shulltronics/kicad_library/parts_inventory.ods

Sheet: Parts Inventory
Shulltronics PN | Description | Category | Part Type | Manufacturer | Manufacturer PN | Supplier A | Supplier A PN | Supplier B | Supplier B PN | Unit Cost
3000 | 5mm 940nm LEDs Infrared Emitter and IR Receiver Diode, 10pk | Optoelectonics | THT | Gikfun | EK8443 | Amazon | B01HGIQ8NG |  |  | $5.78
3001 | CONN SOCKET 22-24AWG CRIMP TIN | Connectors | N/A | Molex | 16020086 | Digikey | WM2510CT-ND |  |  | $0.23
3002 | Sensor Photodiode 3mm 940nm Radial | Optoelectonics | THT | Everlight Electronics | PD204-6C | Digikey | 1080-1140-ND |  |  | $0.47
3003 | EMITTER IR 940NM 100MA RADIAL | Optoelectonics | THT | Everlight Electronics | IR333-A | Digikey | 1080-1080-ND |  |  | $0.44
3004 | RES 475 OHM 1/4W 1% AXIAL | Passives | THT | Yageo | MFR-25FBF52-475R | Digikey | 475XBK-ND |  |  | $0.10
3005 | RES 22.1K OHM 1/4W 1% AXIAL | Passives | THT | Yageo | MFR-25FBF52-22K1 | Digikey | 22.1KXBK-ND |  |  | $0.10
3006 | RES 2.21K OHM 1/4W 1% AXIAL | Passives | THT | Yageo | MFR-25FBF52-2K21 | Digikey | 2.21KXBK-ND |  |  | $0.10
3007 | RES 33.2K OHM 1/4W 1% AXIAL | Passives | THT | Yageo | MFR-25FBF52-33K2 | Digikey | 33.2KXBK-ND |  |  | $0.10
3008 | RES 10K OHM 1/4W 1% AXIAL | Passives | THT | Yageo | MFR-25FBF52-10K | Digikey | 10.0KXBK-ND |  |  | $0.10
3009 | RES 221 OHM 1/4W 1% AXIAL | Passives | THT | Yageo | MFR-25FBF52-221R | Digikey | 221XBK-ND |  |  | $0.10
3010 | 0.1µF -20%, +80% 25V Ceramic Capacitor Y5V (F) Radial | Passives | THT | Vishay BC Components | K104Z15Y5VE5TL2 | Digikey | BC1148CT-ND |  |  | $0.25
3011 | SWITCH PUSH SPST-NO 0.01A 12V BLACK | Passives | THT | Cherry Americas LLC | MX1A-11NN | Digikey | CH162-ND |  |  | $0.93
3012 | Graphic LCD 128x64 STN YLW-GRN LED Backlight | Optoelectonics | THT | Sparkfun Electronics | LCD-00710 | Sparkfun Electronics | LCD-00710 |  |  | $23.95
3013 | Resistive Touch screen - 3.7" Diagonal | Passives | N/A | Adafruit | 333 | Digikey | 1528-1221-ND |  |  | $5.95
3014 | Adafruit Touch Screen Breakout Board for 4 pin 1.0mm FPC | PCB | THT | Adafruit | 3575 | Digikey | 1528-2358-ND |  |  | $2.50
3015 | Feather Teensy 3.x Adapter | Development Board | THT | Adafruit | 3200 | Digikey | 1528-1721-ND |  |  | $5.95
3016 | Trimmer 10k Ohm 0.5W PC Pin Top | Passives | THT | Bourns Inc | 3362P-1-103LF | Digikey | 3362P-1-103LF |  |  | $1.02
3017 | 7 Segment Display 0.3” YLW-GRN 10DIP | Optoelectonics | THT | Inolux | INND-TS30YGAB | Digikey | 1830-1145-ND |  |  | $1.21
3018 | 7 Segment Display 0.3” RED 10DIP | Optoelectonics | THT | Inolux | INND-TS30RAB | Digikey | 1830-1146-ND |  |  | $1.21
3019 | LED Backlighting FSTN (-) Transmiss Black Backround | Optoelectonics | THT | Electronic Assembly | EA DOGXL160S-7 | Mouser | 790-EADOGXL160S-7 |  |  | $22.34
3020 | LED Backlighting Red LED Backlight For DOG-XL Series | Optoelectonics | THT | Electronic Assembly | EA LED78x64-R | Mouser | 790-EALED78X64-R |  |  | $6.83
3021 | 7 Segment Display 0.3” RED 14DIP | Optoelectonics | THT | Hewlett-Packard | 5082-7730 | Electronic Surplus | 150017 |  |  | $3.88
3022 | OBD-II UART Interface Board | Development Board | N/A | Sparkfun Electronics | WIG-09555 | Digikey | 1568-1277-ND |  |  | $52.95
3023 | 0.4" Single Dig. Red Alphanumeric SMD LED Display | Optoelectonics | SMT | Kingbright | ACPSA04-41SRWA | Mouser | 604-ACPSA04-41SRWA |  |  | $4.03
3024 | 8-bit Shift Register 16-DIP | Integrated Circuits | THT | Texas Instruments | SN74HC595N | Digikey | 296-1600-5-ND |  |  | $0.57
3025 | Logic 8-bit Shift Register 16SOIC | Integrated Circuits | SMT | Texas Instruments | TPIC6C596DRG4 | Digikey | 296-22435-1-ND |  |  | $1.10
3026 | Resistor 470 Ohm 1% 1/8W SMD 0402 | Passives | SMT | TE Connectvity Passive Product | CRGP0402F470R | Digikey | A130351CT-ND |  |  | $0.10
3027 | Header Vertical 9pos 0.1” | Connectors | THT | Würth Elektronik | 61300911121 | Digikey | 732-5322-ND |  |  | $0.41
3028 | Conn SL Vert 2pos 2.54mm | Connectors | THT | Molex | 705430036 | Digikey | WM4824-ND |  |  | $0.84
3029 | Conn SL R/A 2pos 2.54mm | Connectors | THT | Molex | 705530036 | Digikey | WM4924-ND |  |  | $1.07
3030 | Conn SL Vert 3pos 2.54mm | Connectors | THT | Molex | 705430037 | Digikey | WM4825-ND |  |  | $0.89
3031 | Conn SL R/A 3pos 2.54mm | Connectors | THT | Molex | 705530037 | Digikey | WM4925-ND |  |  | $1.02
3032 | Conn SL Vert 4pos 2.54mm | Connectors | THT | Molex | 705430038 | Digikey | WM4826-ND |  |  | $0.96
3033 | Conn SL R/A 4pos 2.54mm | Connectors | THT | Molex | 705530038 | Digikey | WM4926-ND |  |  | $1.00
3034 | Conn SL Vert 5pos 2.54mm | Connectors | THT | Molex | 705430039 | Digikey | WM4827-ND
3035 | Conn SL R/A 5pos 2.54mm | Connectors | THT | Molex | 705530039 | Digikey | WM4927-ND
3036 | Conn SL Vert 6pos 2.54mm | Connectors | THT | Molex | 705430040 | Digikey | WM4828-ND
3037 | Conn SL R/A 6pos 2.54mm | Connectors | THT | Molex | 705530040 | Digikey | WM4928-ND
3038 | Conn SL Vert 7pos 2.54mm | Connectors | THT | Molex | 705430041 | Digikey | WM4829-ND
3039 | Conn SL R/A 7pos 2.54mm | Connectors | THT | Molex | 705530041 | Digikey | WM4929-ND
3040 | Conn SL Vert 8pos 2.54mm | Connectors | THT | Molex | 705430042 | Digikey | WM4830-ND |  |  | $1.55
3041 | Conn SL R/A 8pos 2.54mm | Connectors | THT | Molex | 705530042 | Digikey | WM4930-ND |  |  | $2.67
3042 | Sensor Temp/Hum/Press I2C/SPI BME280 | Development Board | THT | Adafruit | 2652 | Digikey | 1528-1359-ND |  |  | $19.95
3043 | Adafruit Si7021 Temperature & Humidity Sensor Breakout Board | Development Board | THT | Adafruit | 3251 | Mouser | 485-3251 | Digikey | 1528-1771-ND | $8.95
3044 | Logic Level Converter – Bi-Directional | Development Board | THT | Sparkfun Electronics | BOB-12009 | Digikey | 1568-1209-ND | Mouser | 474-BOB-12009 | $2.95
3045 | PowerBoost 500 Recharge 5V Lipo | Development Board | THT | Adafruit | 1944 | Mouser | 485-1944 | Digikey | 1528-1486-ND | $14.95
3046 | Conn Header Vert 3pos 2.54mm | Connectors | THT | Würth Elektronik | 61300311121 | Digikey | 732-5316-ND |  |  | $0.13
3047 | Conn Header Vert 2pos 2.54mm | Connectors | THT | Würth Elektronik | 61300211121 | Digikey | 732-5315-ND |  |  | $0.13
3048 | Slide Switch SPDT Through Hole, Right Angle | Passives | THT | E-Switch | EG1213 | Digikey | EG1906-ND |  |  | $0.65
3049 | Linear Voltage Regulator IC 1 Output 100mA TO-92-3 | Regulators | THT | STMicroelectronics | L78L33ABZ-AP | Digikey | 497-7287-1-ND |  |  | $0.36
3050 | Connector Header Through Hole 6 position 0.100" (2.54mm) | Connectors | THT | Würth Elektronik | 61200621621 | Digikey | 732-5394-ND |  |  | $0.45
3051 | Relay SPDT Sealed, 250V 5A, 5V Signal | Electro-Mechanical | THT | Sparkfun Electronics | COM-00100 | Mouser | 474-COM-00100 |  |  | $2.25
3052 | BJT NPN 40V 200mA 300MHz 625mW Through Hole TO-92-3 | Semiconductor | THT | ON Semiconductor | 2N3904BU | Digikey | 2N3904FS-ND |  |  | $0.20
3053 | Diode Standard 100V 200mA Through Hole DO-35 | Semiconductor | THT | ON Semiconductor | 1N4148 | Digikey | 1N4148FS-ND |  |  | $0.10
3054 | CONN PIN 22-24AWG CRIMP TIN | Connectors | N/A | Molex | 16020107 | Digikey | WM2517CT-ND
3055 | CONN HOUSING MALE 2POS .100 | Connector Housings | N/A | Molex | 701070001 | Digikey | WM2533-ND
3056 | CONN HOUSING MALE 3POS .100 | Connector Housings | N/A | Molex | 701070002 | Digikey | WM2534-ND
3057 | CONN HOUSING MALE 4POS .100 | Connector Housings | N/A | Molex | 701070003 | Digikey | WM2535-ND
3058 | CONN HOUSING MALE 5POS .100 | Connector Housings | N/A | Molex | 701070004 | Digikey | WM2536-ND
3059 | CONN HOUSING MALE 6POS .100 | Connector Housings | N/A | Molex | 701070005 | Digikey | WM2537-ND
3060 | CONN HOUSING MALE 7POS .100 | Connector Housings | N/A | Molex | 701070006 | Digikey | WM2538-ND
3061 | CONN HOUSING MALE 8POS .100 | Connector Housings | N/A | Molex | 701070007 | Digikey | WM2539-ND
3062 | CONN HOUSING 2POS .100 W/LATCH | Connector Housings | N/A | Molex | 50579402 | Digikey | WM2900-ND
3063 | CONN HOUSING 3POS .100 W/LATCH | Connector Housings | N/A | Molex | 50579403 | Digikey | WM2901-ND |  |  | $0.23
3064 | CONN HOUSING 4POS .100 W/LATCH | Connector Housings | N/A | Molex | 50579404 | Digikey | WM2902-ND
3065 | CONN HOUSING 5POS .100 W/LATCH | Connector Housings | N/A | Molex | 50579405 | Digikey | WM2903-ND
3066 | CONN HOUSING 6POS .100 W/LATCH | Connector Housings | N/A | Molex | 50579406 | Digikey | WM2904-ND
3067 | CONN HOUSING 7POS .100 W/LATCH | Connector Housings | N/A | Molex | 50579407 | Digikey | WM2905-ND
3068 | CONN HOUSING 8POS .100 W/LATCH | Connector Housings | N/A | Molex | 50579408 | Digikey | WM2906-ND
3069 | CAP ALUM 2.2UF 20% 35V RADIAL | Passives | THT | Nichicon | UMA1V2R2MCD2 | Digikey | 493-17654-ND
3070 | RES 10M OHM 1/4W 5% AXIAL | Passives | THT | Yageo | HHV-25JR-52-10M | Digikey | 10MAACT-ND
3071 | CAP ALUM 10UF 20% 35V RADIAL | Passives | THT | Nichicon | UMA1V100MDD | Digikey | 493-5960-ND |  |  |  | OBSOLETE: possible replacement DK: EEA-GA1v100
3072 | 2N7000 MOSFET
3073 | Touch Screen Breakout Board for 4 pin 1.0mm FPC | Development Board | THT | Adafruit | 3575 | Digikey | 1528-2358-ND
3074 | Adafruit HUZZAH32 Feather | Development Board |  | Adafruit
3075 | MIDI DIN-5 Connector | Connectors | THT | CUI Devices | SDS-50J | Digikey | CP-2350-ND
3076 | OptoIsolator 6N135 | Integrated Circuits | THT
3077 | IC Inverter Schmitt 6ch 14dip | Integrated Circuits | THT | Texas Instruments | SN74HC14N | Digikey | 296-1577-5-ND
3078 | Audio Codec Shield | Development Board | THT | Open Music Labs
3079 | Jack Stereo 3.5mm SMD R/A | Connectors | SMT | CUI Devices | SJ1-3515-SMT-TR | Digikey | CP1-3515SJTR-ND
3080 | MiniJack Mono R/A | Connectors | THT | Switchcraft
3081 | BC556 | Semiconductor | THT
3082 | Led Yellow Diff 3mm Round THT | Optoelectonics | THT | Würth Elektronik | 151031YS06000 | Digikey | 732-5010-ND
3083 | TL072
3084 | Potentiometer (see value in schematic)
3085 | 3.5mm Jack, Vertical, TH PCB Mount | Connectors | THT |  |  | Thonk | PJ398SM |  |  | $0.40
3086 | 2x5 Male Pin Header, Eurorack Power, SMT | Connectors | SMT | Amphenol ICC | 10129383-910001ALF | Digikey | 609-10129383-910001ALFCT-ND
3087 | Potentiometer 10k, Single gang, Board Mount | Electro-Mechanical | THT | TT Electronics/BI | P0915N-FC20BR10K | Digikey | 987-1762-ND
3088 | Capacitor, 10uF 50V, Electrolytic, SMD | Passives | SMT | Würth Elektronik | 865080642006 | Digikey | 732-8451-1-ND
3089 | Capacitor, 100nF 16V, Ceramic, SMD | Passives | SMT | Samsung Electro-Mechanics | CL05A104KA5NNNC | Digikey | 1276-1043-1-ND
3090 | ARM Cortex-M0 Microcontroller, 32-bit, 32KB Flash, 32KB RAM, 32-pin TQFP | Integrated Circuits | SMT | Microchip Technology | ATSAMD21E15B-AUT | Digikey | ATSAMD21E15B-AUTCT-ND
3091 | Capacitor, 47uF 35V, Electrolytic, SMD | Passives | SMT | Würth Elektronik | 865080543009 | Digikey | 732-8508-1-ND
3092 | DAC, Dual 12-bit Output, SPI Interface, MSOP-10 | Integrated Circuits | SMT | Microchip Technology | MCP48FEB22-E/UN | Digikey | MCP48FEB22-E/UN-ND
3093 | LDO Linear Regulator, 3.3V 150mA Output, SOT23-5 | Regulators | SMT | Microchip Technology | MIC5225-3.3YM5-TR | Digikey | 576-2980-1-ND
3094 | Rotary Encoder, 24PPR, Momentary Switch | Electro-Mechanical | THT | Bourns Inc | PEC11R-4220F-S0024 | Digikey | PEC11R-4220F-S0024-ND
3095 | Linear Regulator, Adjustable Output, 100mA, SOT89-3 | Regulators | SMT | Texas Instruments | LM317LIPK | Digikey | 296-21742-1-ND
3096 | USB Type C Connector, Right Angle | Connectors | SMT | Molex | 2171790001 | Digikey | 900-2171790001CT-ND
3097 | TFT Display Breakout Board, 1.14”, SPI Interface | Development Board | THT | Adafruit | 4383 | Digikey | 1528-4383-ND
3098 | Audio Amplifiers Pre-Trimmed Analog Engine IC - QSOP16 | Integrated Circuits | SMT | THAT | THAT4305 | Mouser | 887-4305Q16-U
3099 | Operational Amplifiers - Op Amps Quad Low-Noise JFET-Input | Integrated Circuits | SMT | Texas Instruments | TL074CPW | Mouser | 595-TL074CPW
4000 | Headers & Wire Housings WR-PHD 2.54mm 10Pin THT Header | Connectors | THT | Würth Elektronik | 61301011121 | Mouser | 710-61301011121 | Digikey | 732-2670-ND

Sheet: Suppliers
Supplier Name
Amazon
Digikey
McMaster-Carr
Sparkfun Electronics
Mouser
Electronic Surplus
Thonk

Sheet: Manufacturers
Manufacturer
Adafruit
Gikfun
Infineon
Molex
Texas Instruments
Sparkfun Electronics
Yageo
Everlight Electronics
Vishay BC Components
Cherry Americas LLC
Bourns Inc
Inolux
Electronic Assembly
Hewlett-Packard
Kingbright
TE Connectvity Passive Product
Würth Elektronik
E-Switch
STMicroelectronics
ON Semiconductor
Nichicon
CUI Devices
Open Music Labs
Switchcraft
TT Electronics/BI
Samsung Electro-Mechanics
Microchip Technology
Amphenol ICC
THAT

Sheet: Categories
Electrical | Component | Optoelectonics
 |  | Crimps
 |  | Connector Housings
 |  | Connectors
 |  | Integrated Circuits
 |  | Passives
 |  | Regulators
 |  | Electro-Mechanical
 |  | Semiconductor
 | Assembly | Development Board
 |  | PCB
Mechanical
