shulltronics/kicad_library/shulltronics_kicad_models/3079_CUI_DEVICES_SJ1-3515-SMT-TR.step

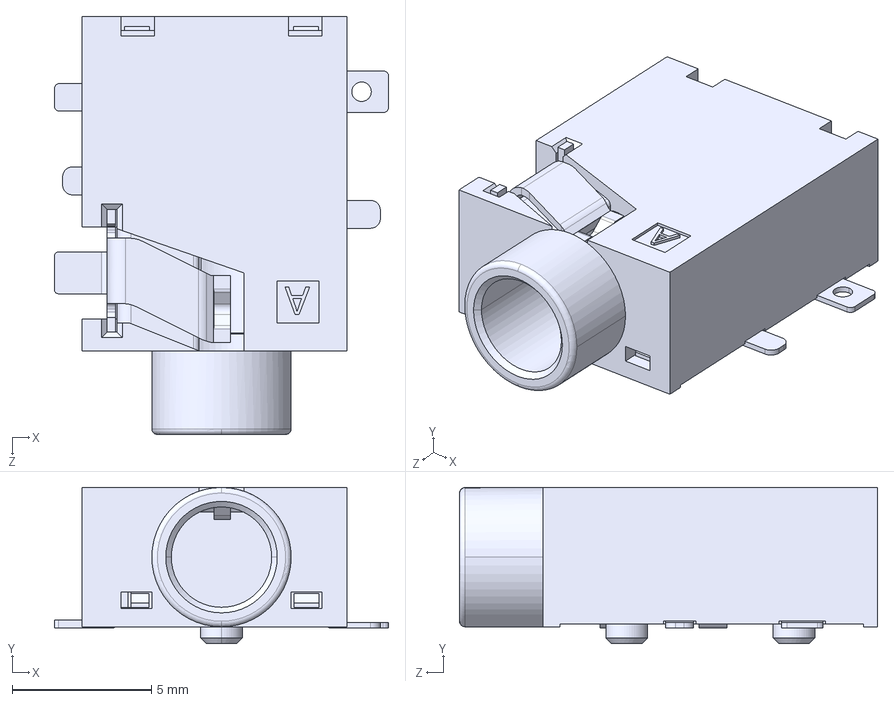
[picture p1: CAD file, 2024-09-27]
shulltronics_kicad_models/3079_CUI_DEVICES_SJ1-3515-SMT-TR.step
12.0 x 5.60 x 15.0 mm
