shulltronics/kicad_library/shulltronics_kicad_models/4012_SMD_025816_WRE.step

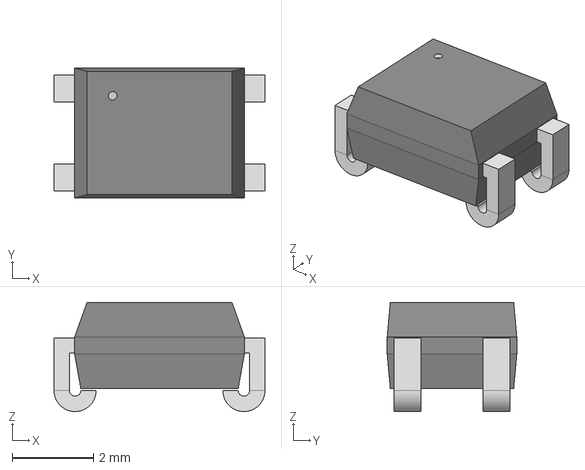
[picture p2: CAD file, 2023-08-17]
shulltronics_kicad_models/4012_SMD_025816_WRE.step
5.21 x 3.20 x 2.69 mm
