shulltronics/kicad_library/shulltronics_kicad_models/4067_M-MSPE-J2L0-B00-REVT3.STEP

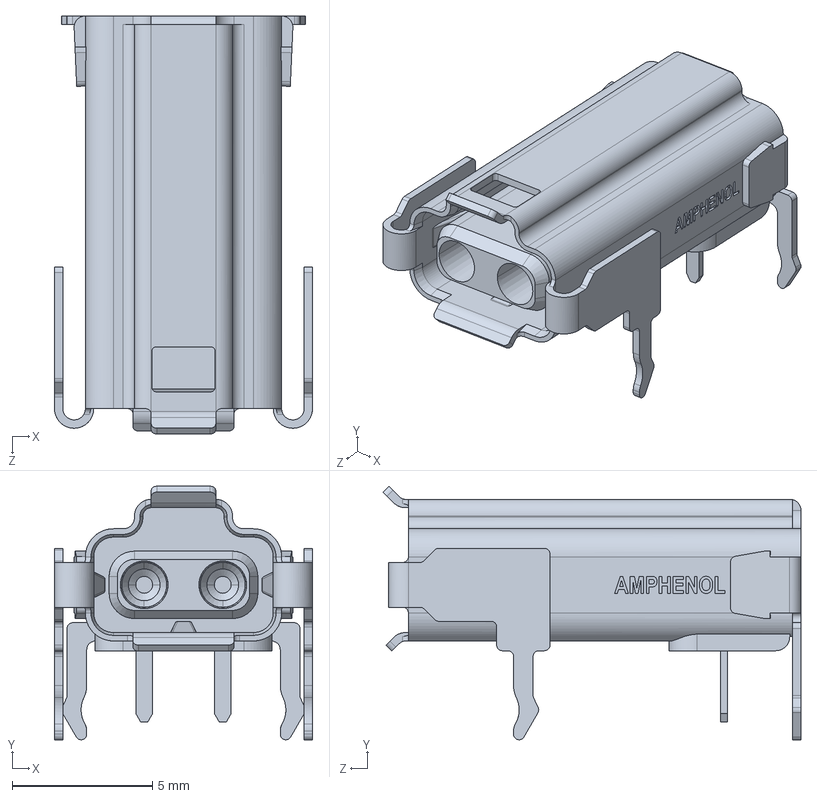
[picture p3: CAD file, 2023-08-17]
shulltronics_kicad_models/4067_M-MSPE-J2L0-B00-REVT3.STEP
9.20 x 9.04 x 14.9 mm
