shulltronics/kicad_library/shulltronics_kicad_models/4049_DF40HC(3.5)-80DS.stp

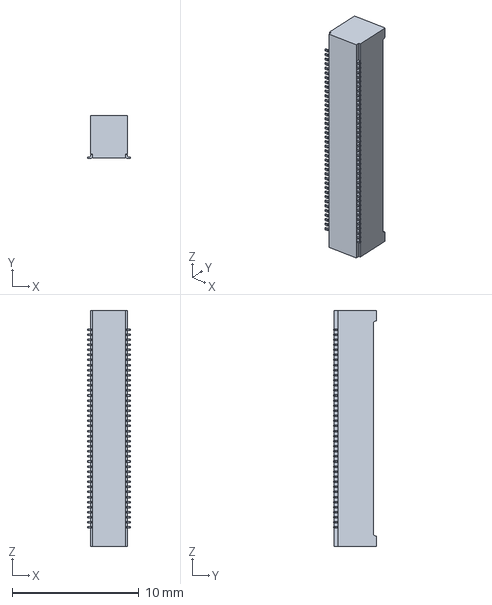
[picture p4: CAD file, 2023-01-25]
shulltronics_kicad_models/4049_DF40HC(3.5)-80DS.stp
3.38 x 3.40 x 18.6 mm
