shulltronics/kicad_library/shulltronics_kicad_models/TQFP32_MC_MCH.step

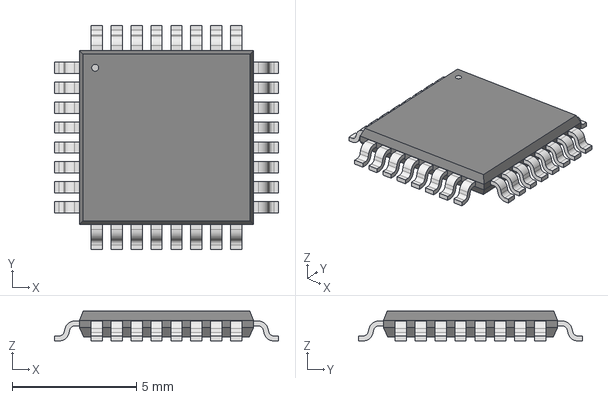
[picture p5: CAD file, 2021-11-29]
shulltronics_kicad_models/TQFP32_MC_MCH.step
9.00 x 9.00 x 1.20 mm
