shulltronics/kicad_library/shulltronics_kicad_models/pec11r-4x20f-sxxxx.stp

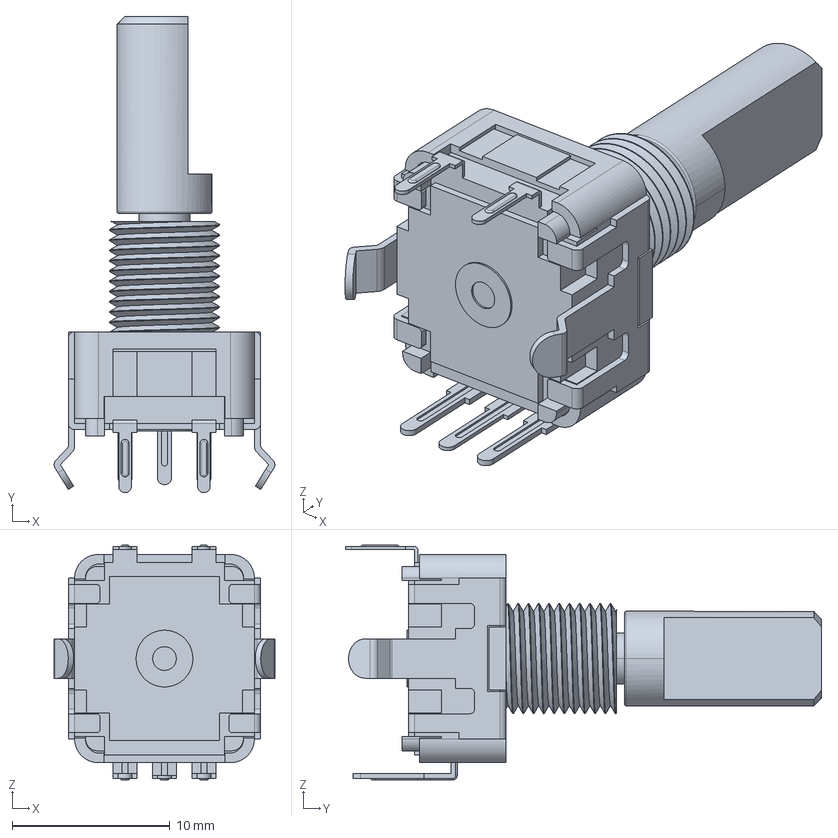
[picture p6: CAD file, 2021-11-29]
shulltronics_kicad_models/pec11r-4x20f-sxxxx.stp
14.0 x 30.2 x 14.9 mm
