shulltronics/kicad_library/shulltronics_kicad_models/3088_10uF_SMD_cap.stp

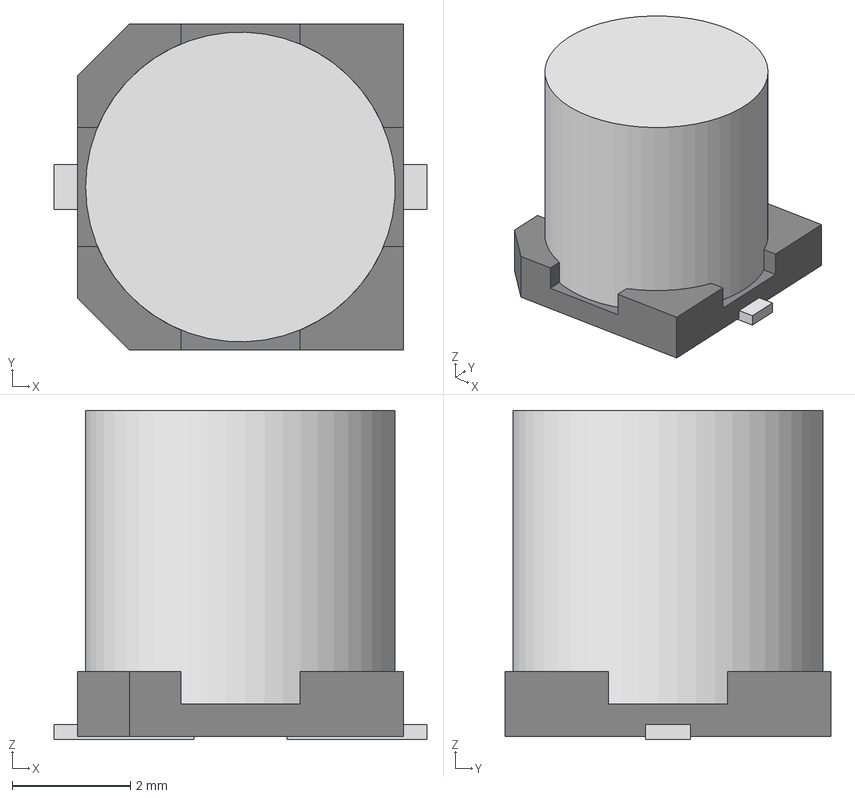
[picture p7: CAD file, 2021-11-29]
shulltronics_kicad_models/3088_10uF_SMD_cap.stp
6.30 x 5.51 x 5.57 mm
