shulltronics/kicad_library/shulltronics_kicad_models/3092-MSOP-10.stp

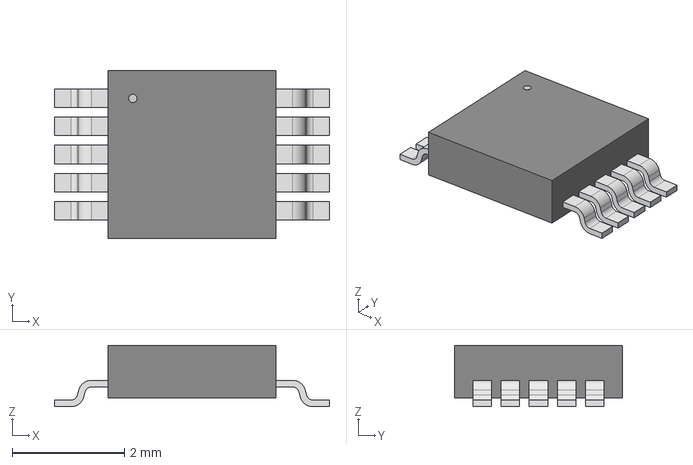
[picture p8: CAD file, 2021-11-29]
shulltronics_kicad_models/3092-MSOP-10.stp
4.90 x 3.00 x 1.09 mm
