shulltronics/kicad_library/shulltronics_kicad_models/3086-2x5-header.stp

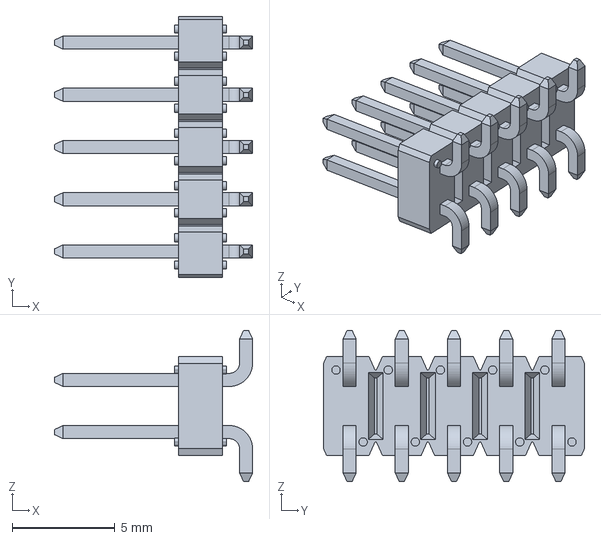
[picture p9: CAD file, 2021-11-29]
shulltronics_kicad_models/3086-2x5-header.stp
9.65 x 12.7 x 7.37 mm
