shulltronics/kicad_library/shulltronics_kicad_models/PJ398SM.step

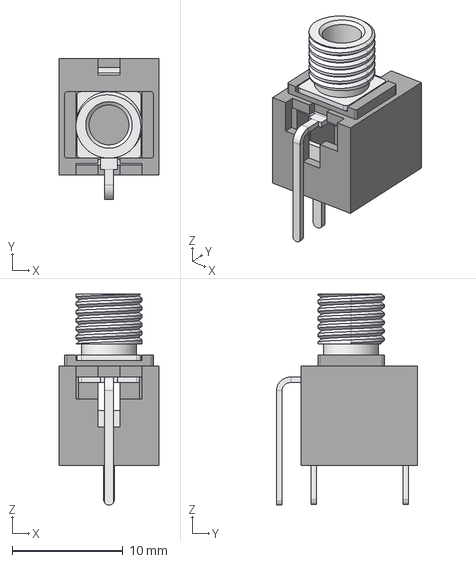
[picture p10: CAD file, 2021-11-29]
shulltronics_kicad_models/PJ398SM.step
9.00 x 12.7 x 19.1 mm
