shulltronics/kicad_library/shulltronics_kicad_models/SOT-89-3.stp

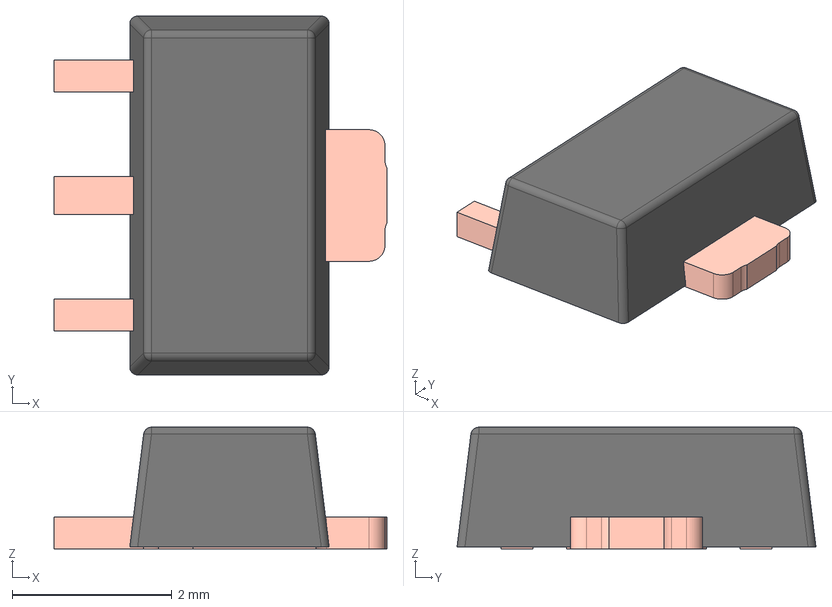
[picture p11: CAD file, 2021-11-29]
shulltronics_kicad_models/SOT-89-3.stp
4.17 x 4.50 x 1.52 mm
FRAME
MOLD
