shulltronics/kicad_library/shulltronics_kicad_models/2171790001-USBC.stp

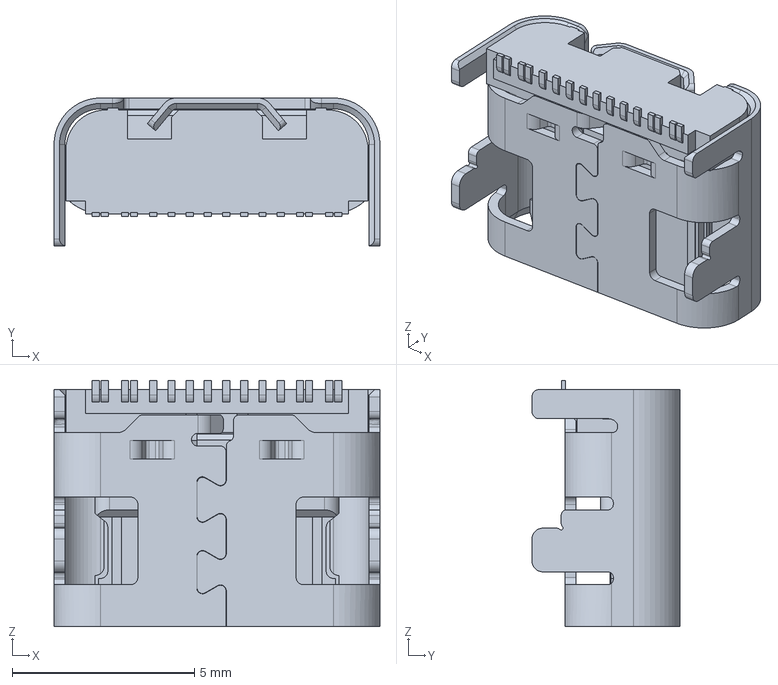
[picture p12: CAD file, 2021-11-29]
shulltronics_kicad_models/2171790001-USBC.stp
8.94 x 4.06 x 6.75 mm
