shulltronics/kicad_library/(commit log)

2021-11-23 KiCad Library!
2021-11-29 More parts
    [2171790001-USBC.stp, 3086-2x5-header.stp, 3088_10uF_SMD_cap.stp, 3092-MSOP-10.stp, PJ398SM.step, SOT-89-3.stp, TQFP32_MC_MCH.step, pec11r-4x20f-sxxxx.stp]
2021-12-20 Added parts for THAT4301 pcb; added parts inventory spreadsheet
    [parts_inventory.ods]
2022-11-07 Pulled in the separate repos to this 'main' one
    [2171790001-USBC.stp, 3086-2x5-header.stp, 3088_10uF_SMD_cap.stp, 3092-MSOP-10.stp, PJ398SM.step, SOT-89-3.stp, TQFP32_MC_MCH.step, pec11r-4x20f-sxxxx.stp]
2022-11-07 Added my work-in-progress BOM generator
2023-01-25 Added DF40 80pin high-density connector (for Portenta x8)
    [4049_DF40HC(3.5)-80DS.stp]
2023-01-30 Updated pinouts for 4014 5V precision reference IC
2023-02-07 Added Alps Pushbutton switch for gamepad use (SPN 4050)
2023-08-17 a few more parts/modifications for adin1110; added some 3d models too
    [4012_SMD_025816_WRE.step, 4067_M-MSPE-J2L0-B00-REVT3.STEP]
2024-01-10 added couple of symbols and footprints
2024-09-27 additions for piezo-preamp-featherwing board
    [3079_CUI_DEVICES_SJ1-3515-SMT-TR.step]
2024-09-27 added analog switch part
2024-09-27 updated bom script and added SPN to a part
